ncsurobotics/SW8E-StandaloneLeakDetector/BOM_June2022Ordering.xlsx

Comment | Description | Designator | Footprint | LibRef | Quantity |  | Legend
BAT-HLD-005-THM | Battery Retainer Coin, 20.0mm 1 Cell PC Pin | BT1 | BAT_BAT-HLD-005-THM | BAT-HLD-005-THM | 1 |  | Already Have
SMTL6-RC |  | D1 | SMTL6-RC | SMTL6-RC | 1 | Only getting 3 because we have some | Unavailable (Substituded another part)
HLMP-EG15-UX000 | No Description Available | D2 | LED_AVAGO_HLMP_XX15_AVA | HLMP-EG15-UX000 | 1 |  | Unavailable (Backorder / did not order)
TSW-102-07-L-S | CONN HEADER VERT 2POS 2.54MM | J1, J2 | FP-TSW-102-07-L-S-MFG | CMP-02766-001428-1 | 2 | Have headers in lab | June 2022 Ordering
Header | CONN HEADER VERT 2POS 2.54MM | J3 | 1x2 Header | 1x2 Header | 1 | Have headers in lab
1M | RES SMD 1M OHM 1% 1/8W 0805 | R1 | SMD-0805-RES | ERJ-6ENF1004V | 1
10k | RES SMD 10K OHM 1% 1/8W 0805 | R2 | SMD-0805-RES | ERJ-6ENF1002V | 1
20 | RES SMD 20 OHM 1% 1/8W 0805 | R3 | SMD-0805-RES | ERJ-6ENF20R0V | 1 | Substituted ERJ-P06J200V
51 | RES SMD 51 OHM 5% 1/8W 0805 | R4 | SMD-0805-RES | ERJ-6GEYJ510V | 1
RES_0.5W_THT | Generic 0.5W through hole resistor | R5 | RES_0.5W_THT | RES_0.5W_THT | 1 | Nothing to order. Footprint for through hole res
QS6J11TR | No Description Available | U1 | TRANS_QS6_ROM | QS6J11TR | 1 | Digikey has. Rest of order is mouser
