ncsurobotics/SW8E-StandaloneLeakDetector/ALTIUM_EMBEDDED_MODELS/Pin Header 1x2 TH Pitch 2.54mm.stp

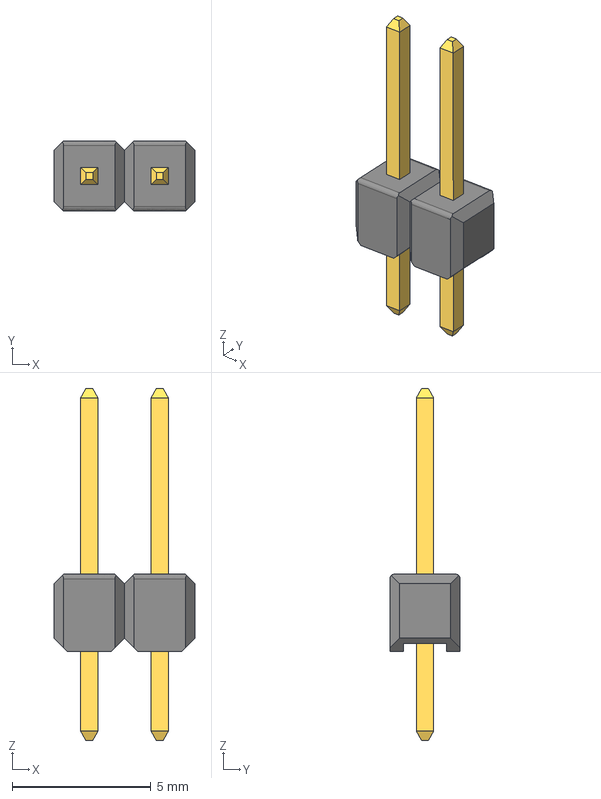
[picture p1: CAD file, 2023-07-04]
ALTIUM_EMBEDDED_MODELS/Pin Header 1x2 TH Pitch 2.54mm.stp
5.08 x 2.54 x 12.7 mm
