ncsurobotics/SW8E-StandaloneLeakDetector/ALTIUM_EMBEDDED_MODELS/TRANS_QS6_ROM.step

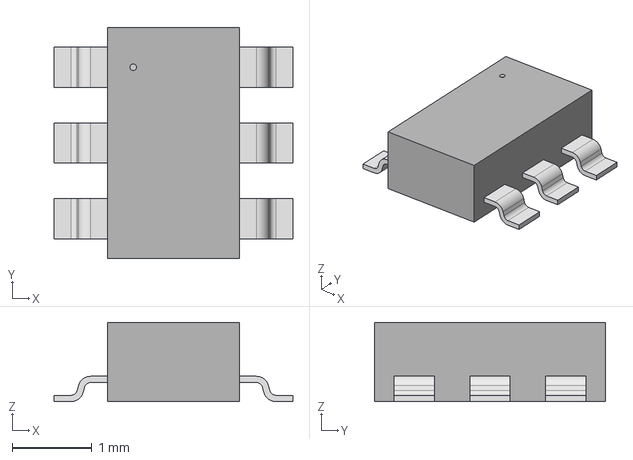
[picture p2: CAD file, 2023-07-04]
ALTIUM_EMBEDDED_MODELS/TRANS_QS6_ROM.step
3.00 x 2.90 x 0.993 mm
