ncsurobotics/SW8E-StandaloneLeakDetector/ALTIUM_EMBEDDED_MODELS/SW3dPS-0805 SMD Resistor.STEP

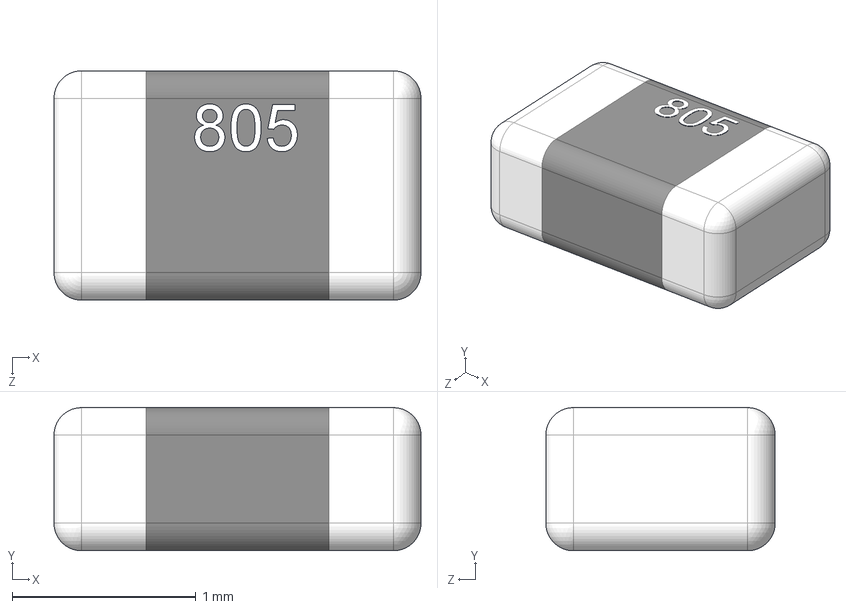
[picture p3: CAD file, 2023-07-04]
ALTIUM_EMBEDDED_MODELS/SW3dPS-0805 SMD Resistor.STEP
2.00 x 0.782 x 1.25 mm
