ncsurobotics/SW8E-StandaloneLeakDetector/ALTIUM_EMBEDDED_MODELS/SMTL6_1673414783.214.step

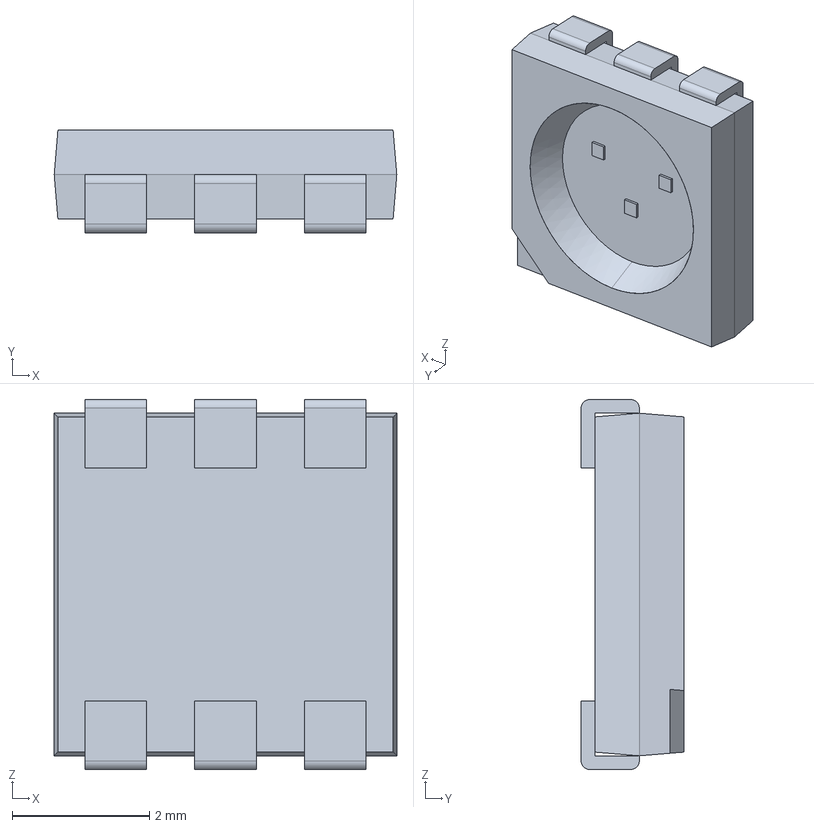
[picture p4: CAD file, 2023-07-04]
ALTIUM_EMBEDDED_MODELS/SMTL6_1673414783.214.step
5.00 x 1.50 x 5.40 mm
eMachineShop.1
eMachineShop.2
eMachineShop.3
eMachineShop.4
eMachineShop.5
eMachineShop.6
eMachineShop.7
eMachineShop.8
eMachineShop.9
eMachineShop.10
eMachineShop.11
eMachineShop.12
eMachineShop.13
eMachineShop.14
eMachineShop.15
eMachineShop.16
eMachineShop.17
eMachineShop.18
eMachineShop.19
eMachineShop.20
eMachineShop.21
eMachineShop.22
eMachineShop.23
eMachineShop.24
eMachineShop.25
eMachineShop.26
eMachineShop.27
eMachineShop.28
eMachineShop.29
eMachineShop.30
eMachineShop.31
eMachineShop.32
eMachineShop.33
eMachineShop.34
eMachineShop.35
eMachineShop.36
eMachineShop.37
eMachineShop.38
eMachineShop.39
eMachineShop.40
eMachineShop.41
eMachineShop.42
eMachineShop.43
eMachineShop.44
eMachineShop.45
eMachineShop.46
eMachineShop.47
eMachineShop.48
eMachineShop.49
eMachineShop.50
eMachineShop.51
eMachineShop.52
eMachineShop.53
eMachineShop.54
eMachineShop.55
eMachineShop.56
eMachineShop.57
eMachineShop.58
eMachineShop.59
eMachineShop.60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
