ncsurobotics/SW8E-StandaloneLeakDetector/ALTIUM_EMBEDDED_MODELS/Conn_SAMTEC_TSW-102-07-L-S_eec.STEP

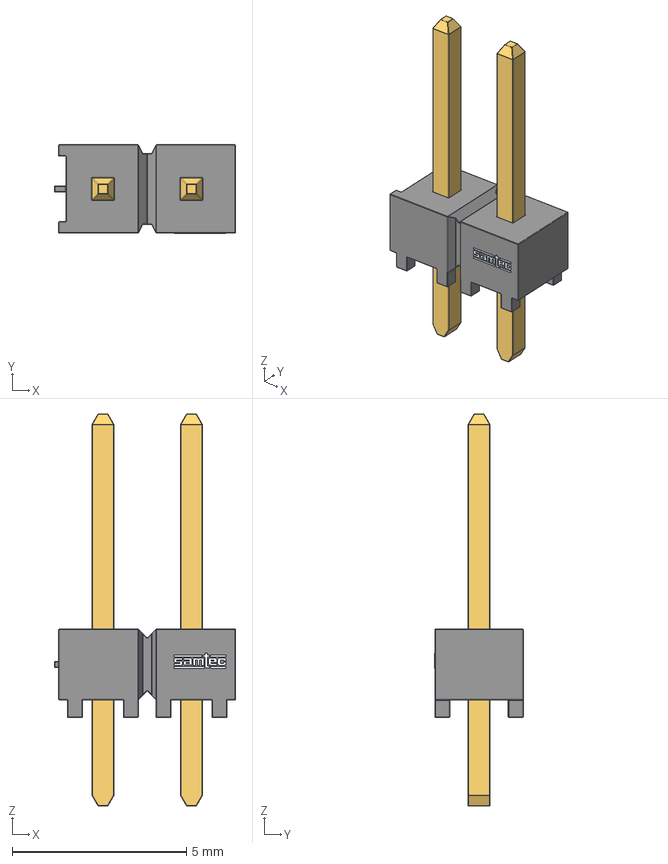
[picture p5: CAD file, 2023-07-04]
ALTIUM_EMBEDDED_MODELS/Conn_SAMTEC_TSW-102-07-L-S_eec.STEP
5.21 x 2.54 x 11.2 mm
TSW-102-07-L-S_body
T-1S6-07-TSW-1-07-2-S
Samtec
