ncsurobotics/SW8E-StandaloneLeakDetector/ALTIUM_EMBEDDED_MODELS/step_temp.STEP

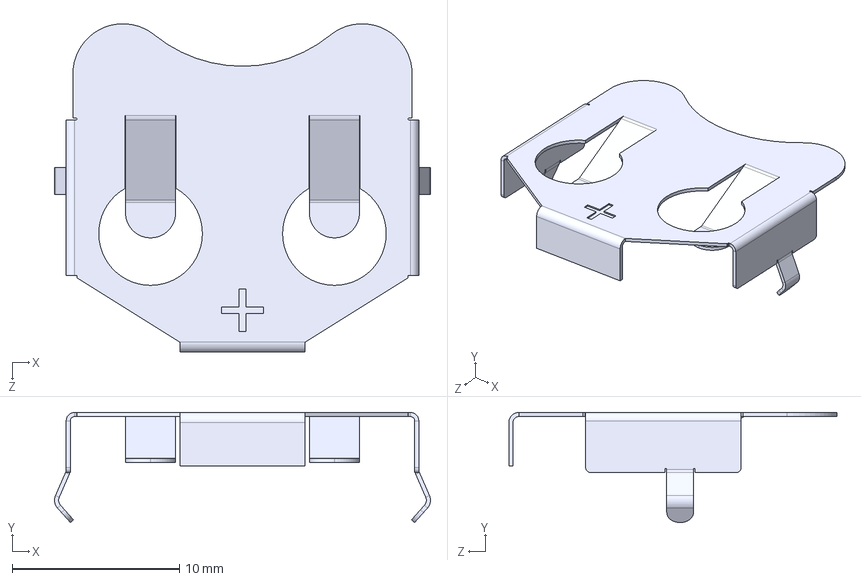
[picture p6: CAD file, 2023-07-04]
ALTIUM_EMBEDDED_MODELS/step_temp.STEP
22.5 x 6.59 x 19.6 mm
