ncsurobotics/SW8E-StandaloneLeakDetector/LTSpiceSim.asc

M1: pmos; QS6J11
R1: res; 1e6
R2: res; 10k
V1: voltage; 3
Named nets: 0, LEAK_OUT
.tran 1s
.model QS6J11 VDMOS(pchan Vds=-12 Ron=105m Qg=1.3n)
LEAK_IN
