ncsurobotics/SW8E-StandaloneLeakDetector/StandaloneLeakDetector.kicad_pcb

## KiCad design StandaloneLeakDetector.kicad_pcb (2023-07-04)

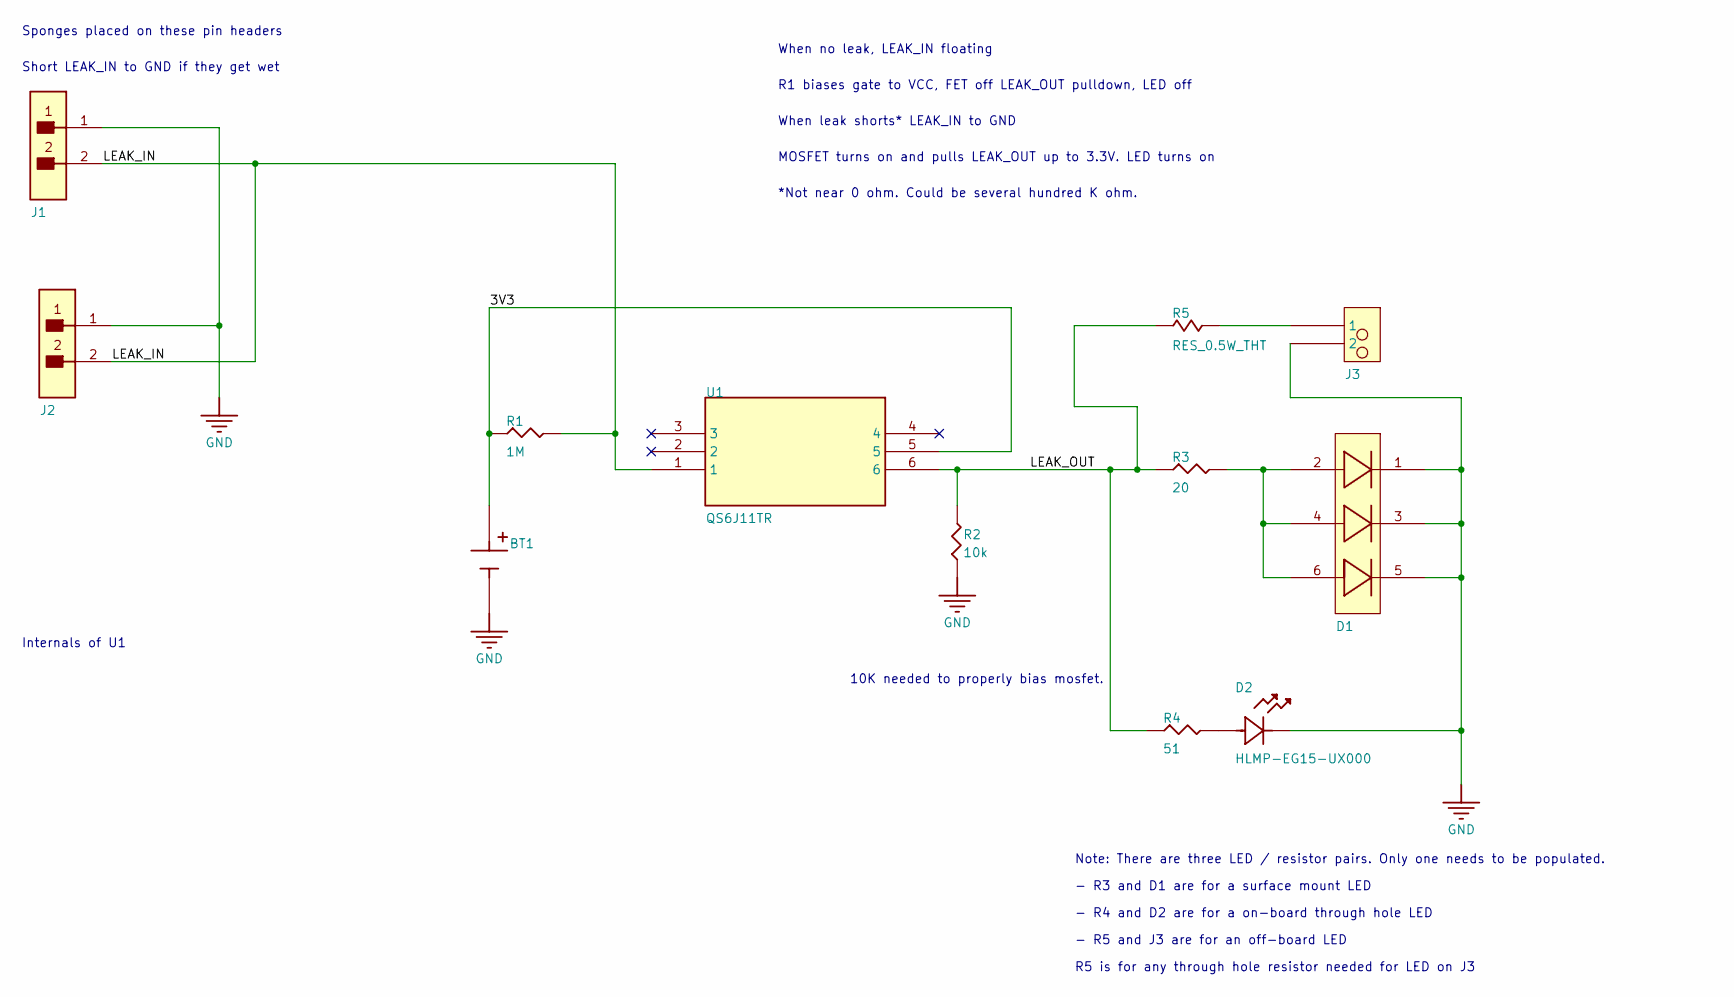
[picture p7: schematic StandaloneLeakDetector.kicad_sch]

Parts:
BT1: BAT-HLD-005-THM; BAT_BAT-HLD-005-THM; Part Number BAT-HLD-005-THM
D1: SMTL6-RC; Part Number SMTL6-RC
D2: HLMP-EG15-UX000; LED_AVAGO_HLMP_XX15_AVA; Part Number HLMP-EG15-UX000
J1, J2: TSW-102-07-L-S; FP-TSW-102-07-L-S-MFG; Part Number TSW-102-07-L-S
J3: Header; 1x2 Header
R1: 1M; SMD-0805-RES; Part Number ERJ-6ENF1004V
R2: 10k; SMD-0805-RES; Part Number ERJ-6ENF1002V
R3: 20; SMD-0805-RES; Part Number ERJ-6ENF20R0V
R4: 51; SMD-0805-RES; Part Number ERJ-6GEYJ510V
R5: RES_0.5W_THT
U1: QS6J11TR; TRANS_QS6_ROM; Part Number QS6J11TR

Connections:
/3V3: BT1.P1 (POS), BT1.P2 (POS), R1.1, U1.5
/LEAK_IN: J1.2, J2.2, R1.2, U1.1
/LEAK_OUT: R2.2, R3.1, R4.1, R5.1, U1.6
GND: BT1.N (NEG), D1.1, D1.3, D1.5, D2.1, J1.1, J2.1, J3.2, R2.1
unnamed: D1.2, D1.4, D1.6, R3.2
unnamed: D2.2, R4.2
unnamed: J3.1, R5.2

Notes on the sheet:
R5 is for any through hole resistor needed for LED on J3
- R3 and D1 are for a surface mount LED
10K needed to properly bias mosfet.
- R5 and J3 are for an off-board LED
Note: There are three LED / resistor pairs. Only one needs to be populated.
When no leak, LEAK_IN floating
- R4 and D2 are for a on-board through hole LED
Internals of U1
R1 biases gate to VCC, FET off LEAK_OUT pulldown, LED off
Sponges placed on these pin headers
MOSFET turns on and pulls LEAK_OUT up to 3.3V. LED turns on
*Not near 0 ohm. Could be several hundred K ohm.
When leak shorts* LEAK_IN to GND
Short LEAK_IN to GND if they get wet

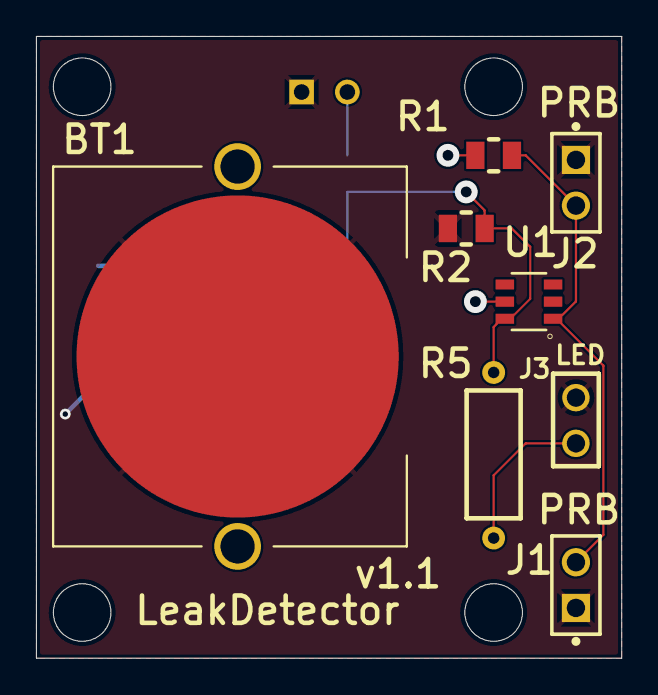
[picture p8: board StandaloneLeakDetector.kicad_pcb from above]

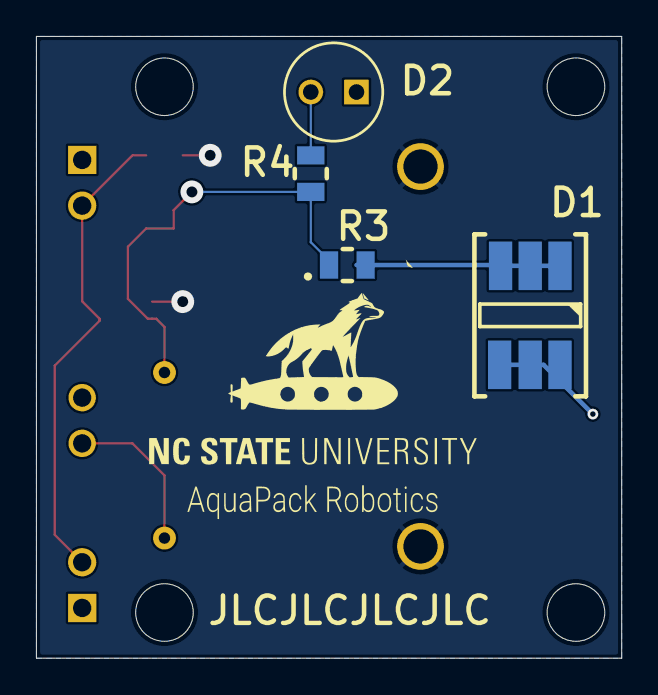
[picture p9: board StandaloneLeakDetector.kicad_pcb from below]

Board: 2 copper layers, 32.5 x 34.5 mm, 12 parts (4 on the bottom side), 7 nets.
