ncsurobotics/SW8E-StandaloneLeakDetector/(commit log)

2022-05-22 Add simulation, schematic, and first revision pcb
    [StandaloneLeakDetector.PcbDoc, StandaloneLeakDetector.PrjPcb, StandaloneLeakDetector.SchDoc]
2022-05-22 Updated header pin order on schematic. Fixed and finished PCB. Using rules for JLC 2 layer 1oz board
    [StandaloneLeakDetector.PcbDoc, StandaloneLeakDetector.PrjPcb, StandaloneLeakDetector.SchDoc]
2022-05-22 Change LED resistor and add info about power consumption in txt document
    [StandaloneLeakDetector.PcbDoc, StandaloneLeakDetector.SchDoc]
2022-05-23 Add mounting holes
    [StandaloneLeakDetector.PcbDoc]
2022-05-23 Add pcb name and version silkscreen
    [StandaloneLeakDetector.PcbDoc]
2022-05-24 Added logos to PCB and added BOM
    [BOM_StandaloneLeakDetector.xlsx, StandaloneLeakDetector.PcbDoc, StandaloneLeakDetector.PrjPcb]
2022-05-24 Added space in board name
    [StandaloneLeakDetector.PcbDoc]
2022-05-24 Moved logo to clear via
    [StandaloneLeakDetector.PcbDoc]
2022-06-29 Added other LED options
    [StandaloneLeakDetector.SchDoc]
2022-06-30 Added two more LED options
    [StandaloneLeakDetector.PcbDoc, StandaloneLeakDetector.SchDoc]
2022-06-30 Add project changes not saved in last commit
    [StandaloneLeakDetector.PrjPcb]
2022-06-30 Updated power calculations notes for three led options
2022-06-30 Add ordering bom
    [BOM_June2022Ordering.xlsx]
2022-06-30 Condensed the board
    [StandaloneLeakDetector.PcbDoc, StandaloneLeakDetector.PrjPcb]
2022-06-30 Added board outline
    [StandaloneLeakDetector.PcbDoc]
2023-04-11 Converted board from Altium to kicad
    [Conn_SAMTEC_TSW-102-07-L-S_eec.STEP, Pin Header 1x2 TH Pitch 2.54mm.stp, SMTL6_1673414783.214.step, SW3dPS-0805 SMD Resistor.STEP, StandaloneLeakDetector.PcbDoc, StandaloneLeakDetector.PrjPcb, StandaloneLeakDetector.SchDoc, StandaloneLeakDetector.kicad_pcb]
2023-07-04 Update gitignore for kicad
2023-07-04 Fix footprint associations
    [BOM_June2022Ordering.xlsx, BOM_StandaloneLeakDetector.xlsx, StandaloneLeakDetector.kicad_pcb, StandaloneLeakDetector.kicad_sch]
2023-07-04 Remove imported symbol table fields
    [StandaloneLeakDetector.kicad_sch]
2023-07-04 Update board settings from template
    [StandaloneLeakDetector.kicad_pcb]
2023-07-04 Mark mounting holes as 'not in schematic'
    [StandaloneLeakDetector.kicad_pcb]
